hjc180926/26mspm0-car/hardware/schematic-V1.0-2026-08-01.pdf

# RGB

# 电源接口DC005+XT60

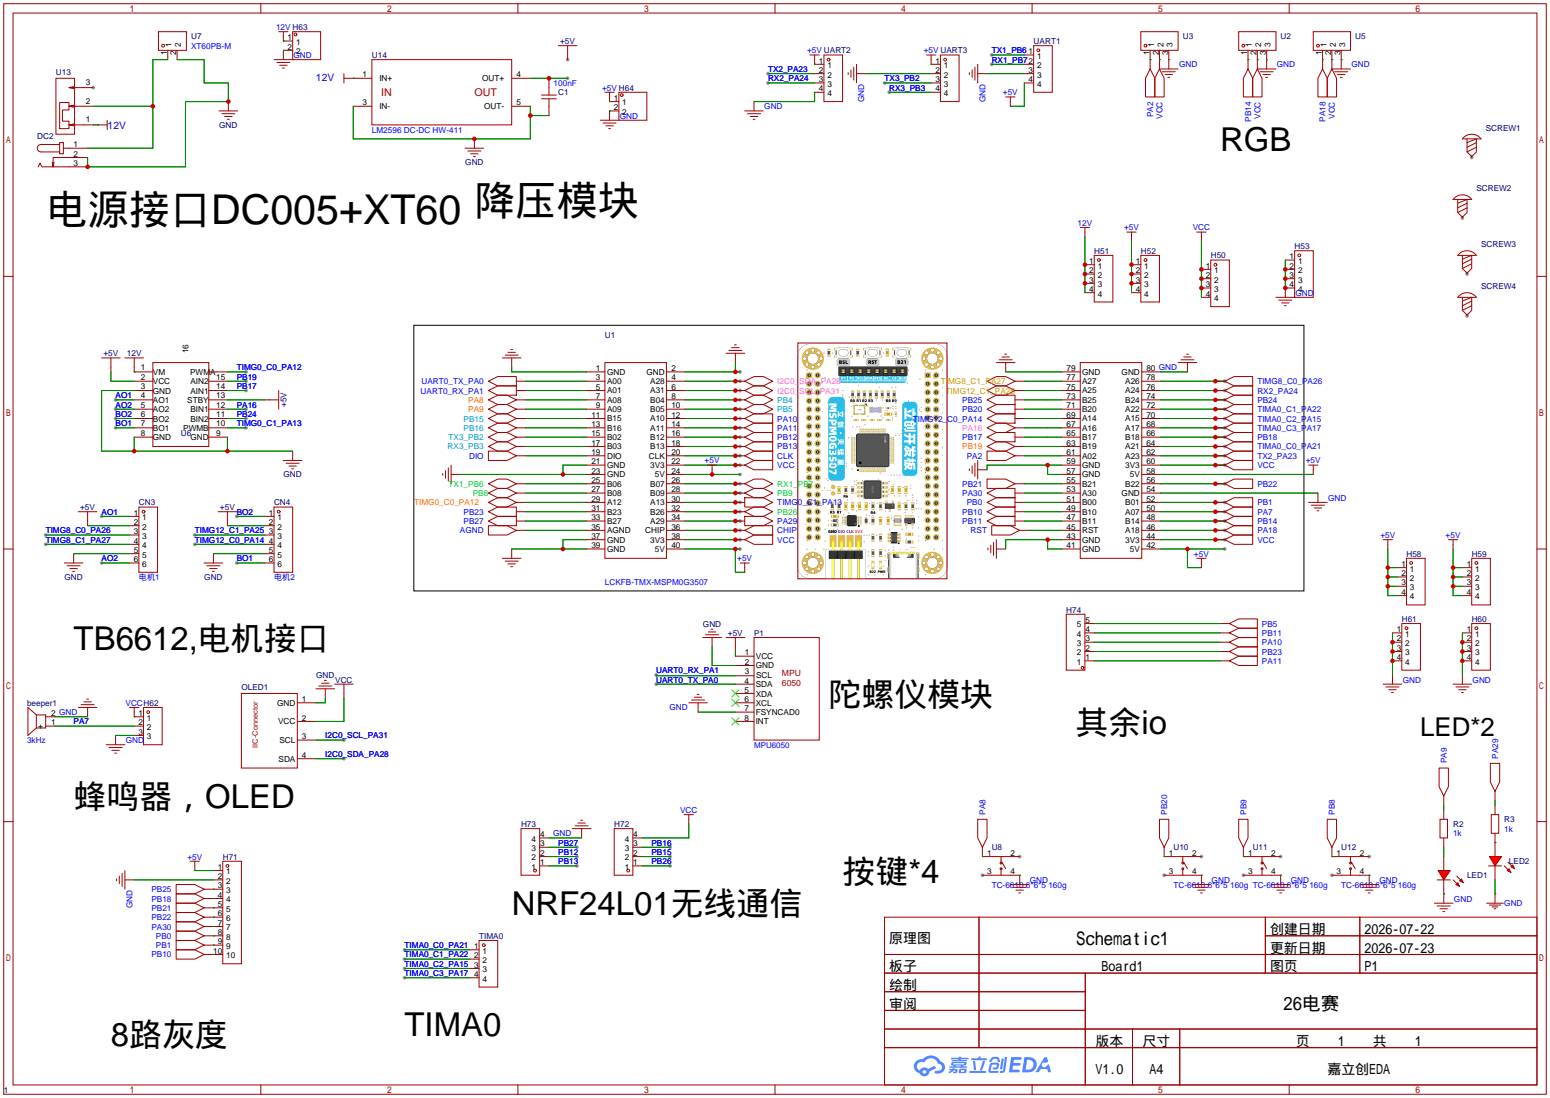
[picture p1: page 1]

PWMB 10 BIN2 11 BIN1 12 STBY 13 AIN1 14 AIN2 15 PWMA ¹⁶

原理图 | Schematic1 | 创建日期 | 2026-07-22

更新日期 | 2026-07-23

板子 | Board1 | 图页 | P1
绘制 | | 26电赛
审阅

V1.0 | A4 | 嘉立创EDA
