hjc180926/26mspm0-car/k230-ball-balance/main.py

import os
import ujson
import aicube
from media.sensor import *
from media.display import *
from media.media import *
from time import *
import nncase_runtime as nn
import ulab.numpy as np
import time
import utime
import image
import gc

# ========== 显示配置 ==========
display_mode = "lcd"
if display_mode == "lcd":
    DISPLAY_WIDTH = ALIGN_UP(800, 16)
    DISPLAY_HEIGHT = 480
else:
    DISPLAY_WIDTH = ALIGN_UP(1920, 16)
    DISPLAY_HEIGHT = 1080

# AI推理通道分辨率
OUT_RGB888P_WIDTH = ALIGN_UP(1080, 16)
OUT_RGB888P_HEIGH = 720

# ========== 颜色配置 ==========
color_four = [(255, 220, 20, 60), (255, 119, 11, 32), (255, 0, 0, 142), (255, 0, 0, 230),
        (255, 106, 0, 228), (255, 0, 60, 100), (255, 0, 80, 100), (255, 0, 0, 70),
        (255, 0, 0, 192), (255, 250, 170, 30), (255, 100, 170, 30), (255, 220, 220, 0),
        (255, 175, 116, 175), (255, 250, 0, 30), (255, 165, 42, 42), (255, 255, 77, 255),
        (255, 0, 226, 252), (255, 182, 182, 255), (255, 0, 82, 0), (255, 120, 166, 157),
        (255, 110, 76, 0), (255, 174, 57, 255), (255, 199, 100, 0), (255, 72, 0, 118),
        (255, 255, 179, 240), (255, 0, 125, 92), (255, 209, 0, 151), (255, 188, 208, 182),
        (255, 0, 220, 176), (255, 255, 99, 164), (255, 92, 0, 73), (255, 133, 129, 255),
        (255, 78, 180, 255), (255, 0, 228, 0), (255, 174, 255, 243), (255, 45, 89, 255),
        (255, 134, 134, 103), (255, 145, 148, 174), (255, 255, 208, 186),
        (255, 197, 226, 255), (255, 171, 134, 1), (255, 109, 63, 54), (255, 207, 138, 255),
        (255, 151, 0, 95), (255, 9, 80, 61), (255, 84, 105, 51), (255, 74, 65, 105),
        (255, 166, 196, 102), (255, 208, 195, 210), (255, 255, 109, 65), (255, 0, 143, 149),
        (255, 179, 0, 194), (255, 209, 99, 106), (255, 5, 121, 0), (255, 227, 255, 205),
        (255, 147, 186, 208), (255, 153, 69, 1), (255, 3, 95, 161), (255, 163, 255, 0),
        (255, 119, 0, 170), (255, 0, 182, 199), (255, 0, 165, 120), (255, 183, 130, 88),
        (255, 95, 32, 0), (255, 130, 114, 135), (255, 110, 129, 133), (255, 166, 74, 118),
        (255, 219, 142, 185), (255, 79, 210, 114), (255, 178, 90, 62), (255, 65, 70, 15),
        (255, 127, 167, 115), (255, 59, 105, 106), (255, 142, 108, 45), (255, 196, 172, 0),
        (255, 95, 54, 80), (255, 128, 76, 255), (255, 201, 57, 1), (255, 246, 0, 122),
        (255, 191, 162, 208)]

# ========== 模型路径配置 ==========
root_path = "/sdcard/mp_deployment_source/"
config_path = root_path + "deploy_config.json"
deploy_conf = {}
debug_mode = 1

# ========== 位置换算校准参数（必须按实际画面校准） ==========
# 摆杆中心点（0cm刻度）对应的AI画面x像素坐标
CENTER_X_PIXEL = 540
# 每1厘米对应的像素数量（摆杆总长25cm，总像素数 / 25 可得初始值）
PIXEL_PER_CM = 43.2
# ==============================================================

class ScopedTiming:
    def __init__(self, info="", enable_profile=True):
        self.info = info
        self.enable_profile = enable_profile

    def __enter__(self):
        if self.enable_profile:
            self.start_time = time.time_ns()
        return self

    def __exit__(self, exc_type, exc_value, traceback):
        if self.enable_profile:
            elapsed_time = time.time_ns() - self.start_time
            print(f"{self.info} took {elapsed_time / 1000000:.2f} ms")

def read_deploy_config(config_path):
    with open(config_path, 'r') as json_file:
        try:
            config = ujson.load(json_file)
        except ValueError as e:
            print("JSON 解析错误:", e)
    return config

def detection():
    print("=== 钢珠位置检测启动 ===")
    deploy_conf = read_deploy_config(config_path)
    kmodel_name = deploy_conf["kmodel_path"]
    labels = deploy_conf["categories"]
    confidence_threshold = deploy_conf["confidence_threshold"]
    nms_threshold = deploy_conf["nms_threshold"]
    img_size = deploy_conf["img_size"]
    num_classes = deploy_conf["num_classes"]
    nms_option = deploy_conf["nms_option"]
    model_type = deploy_conf["model_type"]
    
    if model_type == "AnchorBaseDet":
        anchors = deploy_conf["anchors"][0] + deploy_conf["anchors"][1] + deploy_conf["anchors"][2]
    
    kmodel_frame_size = img_size
    frame_size = [OUT_RGB888P_WIDTH, OUT_RGB888P_HEIGH]
    strides = [8, 16, 32]

    # 计算padding参数
    ori_w = OUT_RGB888P_WIDTH
    ori_h = OUT_RGB888P_HEIGH
    width = kmodel_frame_size[0]
    height = kmodel_frame_size[1]
    ratiow = float(width) / ori_w
    ratioh = float(height) / ori_h
    ratio = ratiow if ratiow < ratioh else ratioh
    new_w = int(ratio * ori_w)
    new_h = int(ratio * ori_h)
    dw = float(width - new_w) / 2
    dh = float(height - new_h) / 2
    top = int(round(dh - 0.1))
    bottom = int(round(dh + 0.1))
    left = int(round(dw - 0.1))
    right = int(round(dw - 0.1))

    # 初始化KPU和AI2D
    kpu = nn.kpu()
    ai2d = nn.ai2d()
    kpu.load_kmodel(root_path + kmodel_name)
    ai2d.set_dtype(nn.ai2d_format.NCHW_FMT,
                   nn.ai2d_format.NCHW_FMT,
                   np.uint8, np.uint8)
    ai2d.set_pad_param(True, [0,0,0,0,top,bottom,left,right], 0, [114,114,114])
    ai2d.set_resize_param(True, nn.interp_method.tf_bilinear, nn.interp_mode.half_pixel)
    ai2d_builder = ai2d.build([1,3,OUT_RGB888P_HEIGH,OUT_RGB888P_WIDTH], [1,3,height,width])

    # 初始化摄像头
    sensor = Sensor()
    sensor.reset()
    sensor.set_hmirror(False)
    sensor.set_vflip(False)
    sensor.set_framesize(width=DISPLAY_WIDTH, height=DISPLAY_HEIGHT)
    sensor.set_pixformat(PIXEL_FORMAT_YUV_SEMIPLANAR_420)
    sensor.set_framesize(width=OUT_RGB888P_WIDTH, height=OUT_RGB888P_HEIGH, chn=CAM_CHN_ID_2)
    sensor.set_pixformat(PIXEL_FORMAT_RGB_888_PLANAR, chn=CAM_CHN_ID_2)
    
    sensor_bind_info = sensor.bind_info(x=0, y=0, chn=CAM_CHN_ID_0)
    Display.bind_layer(**sensor_bind_info, layer=Display.LAYER_VIDEO1)
    
    if display_mode == "lcd":
        Display.init(Display.ST7701, to_ide=False)
    else:
        Display.init(Display.LT9611, to_ide=False)

    # 创建OSD绘图层
    osd_img = image.Image(DISPLAY_WIDTH, DISPLAY_HEIGHT, image.ARGB8888)
    
    try:
        MediaManager.init()
        sensor.run()
        rgb888p_img = None
        ai2d_input_tensor = None
        data = np.ones((1,3,width,height), dtype=np.uint8)
        ai2d_output_tensor = nn.from_numpy(data)
        
        while True:
            with ScopedTiming("total", debug_mode > 0):
                rgb888p_img = sensor.snapshot(chn=CAM_CHN_ID_2)
                
                if rgb888p_img.format() == image.RGBP888:
                    ai2d_input = rgb888p_img.to_numpy_ref()
                    ai2d_input_tensor = nn.from_numpy(ai2d_input)
                    ai2d_builder.run(ai2d_input_tensor, ai2d_output_tensor)

                    kpu.set_input_tensor(0, ai2d_output_tensor)
                    kpu.run()
                    
                    # 获取模型输出
                    results = []
                    for i in range(kpu.outputs_size()):
                        out_data = kpu.get_output_tensor(i)
                        result = out_data.to_numpy()
                        result = result.reshape((result.shape[0]*result.shape[1]*result.shape[2]*result.shape[3]))
                        del out_data
                        results.append(result)
                    gc.collect()

                    # 目标检测后处理
                    if model_type == "AnchorBaseDet":
                        det_boxes = aicube.anchorbasedet_post_process(
                            results[0], results[1], results[2],
                            kmodel_frame_size, frame_size, strides,
                            num_classes, confidence_threshold, nms_threshold, anchors, nms_option)
                    elif model_type == "GFLDet":
                        det_boxes = aicube.gfldet_post_process(
                            results[0], results[1], results[2],
                            kmodel_frame_size, frame_size, strides,
                            num_classes, confidence_threshold, nms_threshold, nms_option)
                    else:
                        det_boxes = aicube.anchorfreedet_post_process(
                            results[0], results[1], results[2],
                            kmodel_frame_size, frame_size, strides,
                            num_classes, confidence_threshold, nms_threshold, nms_option)
                    
                    osd_img.clear()
                    
                    # ========== 核心：钢珠位置计算与显示 ==========
                    if det_boxes:
                        # 取置信度最高的钢珠（第一个）
                        box = det_boxes[0]
                        cls_id = int(box[0])
                        score = box[1]
                        x1, y1, x2, y2 = box[2], box[3], box[4], box[5]
                        
                        # 1. 计算钢珠中心像素坐标（AI推理帧坐标系）
                        ball_cx_pixel = (x1 + x2) / 2
                        ball_cy_pixel = (y1 + y2) / 2
                        
                        # 2. 像素坐标换算为物理位置（cm，中心点为0，右正左负）
                        ball_pos_cm = (ball_cx_pixel - CENTER_X_PIXEL) / PIXEL_PER_CM
                        
                        # 3. 坐标映射到显示画面尺寸
                        disp_x1 = int(x1 * DISPLAY_WIDTH / OUT_RGB888P_WIDTH)
                        disp_y1 = int(y1 * DISPLAY_HEIGHT / OUT_RGB888P_HEIGH)
                        disp_x2 = int(x2 * DISPLAY_WIDTH / OUT_RGB888P_WIDTH)
                        disp_y2 = int(y2 * DISPLAY_HEIGHT / OUT_RGB888P_HEIGH)
                        disp_cx = int(ball_cx_pixel * DISPLAY_WIDTH / OUT_RGB888P_WIDTH)
                        disp_cy = int(ball_cy_pixel * DISPLAY_HEIGHT / OUT_RGB888P_HEIGH)
                        
                        # 4. 绘制检测框
                        osd_img.draw_rectangle(disp_x1, disp_y1, disp_x2-disp_x1, disp_y2-disp_y1,
                                               color=color_four[cls_id][1:])
                        
                        # 5. 绘制中心点标记
                        osd_img.draw_circle(disp_cx, disp_cy, 4, color=(255,255,0,255), thickness=2)
                        
                        # 6. 左上角叠加显示位置信息
                        info_text = f"位置: {ball_pos_cm:+.2f} cm"
                        pixel_text = f"X像素: {int(ball_cx_pixel)}"
                        score_text = f"置信度: {score:.2f}"
                        
                        osd_img.draw_string_advanced(20, 30, 36, info_text, color=(255,255,0,255))
                        osd_img.draw_string_advanced(20, 75, 28, pixel_text, color=(255,255,255,255))
                        osd_img.draw_string_advanced(20, 110, 28, score_text, color=(255,255,255,255))
                        
                        # 串口同步输出位置，方便校准
                        print(f"钢珠位置: {ball_pos_cm:+.2f} cm | X像素: {int(ball_cx_pixel)}")
                    else:
                        # 未检测到钢珠时的提示
                        osd_img.draw_string_advanced(20, 30, 36, "未检测到钢珠", color=(255,0,0,255))
                    
                    # 显示OSD层
                    Display.show_image(osd_img, 0, 0, Display.LAYER_OSD3)
                    gc.collect()
                
                rgb888p_img = None

    except Exception as e:
        print(f"运行异常: {e}")
        import sys
        sys.print_exception(e)
    finally:
        os.exitpoint(os.EXITPOINT_ENABLE_SLEEP)
        del ai2d_input_tensor
        del ai2d_output_tensor
        sensor.stop()
        Display.deinit()
        MediaManager.deinit()
        gc.collect()
        time.sleep(1)
        nn.shrink_memory_pool()
    print("检测结束")
    return 0

if __name__ == "__main__":
    detection()
