hjc180926/26mspm0-car/ti_msp_dl_config.c

/*
 * Copyright (c) 2023, Texas Instruments Incorporated
 * All rights reserved.
 *
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
 * *  Redistributions of source code must retain the above copyright
 *    notice, this list of conditions and the following disclaimer.
 *
 * *  Redistributions in binary form must reproduce the above copyright
 *    notice, this list of conditions and the following disclaimer in the
 *    documentation and/or other materials provided with the distribution.
 *
 * *  Neither the name of Texas Instruments Incorporated nor the names of
 *    its contributors may be used to endorse or promote products derived
 *    from this software without specific prior written permission.
 *
 * THIS SOFTWARE IS PROVIDED BY THE COPYRIGHT HOLDERS AND CONTRIBUTORS "AS IS"
 * AND ANY EXPRESS OR IMPLIED WARRANTIES, INCLUDING, BUT NOT LIMITED TO,
 * THE IMPLIED WARRANTIES OF MERCHANTABILITY AND FITNESS FOR A PARTICULAR
 * PURPOSE ARE DISCLAIMED. IN NO EVENT SHALL THE COPYRIGHT OWNER OR
 * CONTRIBUTORS BE LIABLE FOR ANY DIRECT, INDIRECT, INCIDENTAL, SPECIAL,
 * EXEMPLARY, OR CONSEQUENTIAL DAMAGES (INCLUDING, BUT NOT LIMITED TO,
 * PROCUREMENT OF SUBSTITUTE GOODS OR SERVICES; LOSS OF USE, DATA, OR PROFITS;
 * OR BUSINESS INTERRUPTION) HOWEVER CAUSED AND ON ANY THEORY OF LIABILITY,
 * WHETHER IN CONTRACT, STRICT LIABILITY, OR TORT (INCLUDING NEGLIGENCE OR
 * OTHERWISE) ARISING IN ANY WAY OUT OF THE USE OF THIS SOFTWARE,
 * EVEN IF ADVISED OF THE POSSIBILITY OF SUCH DAMAGE.
 */

/*
 *  ============ ti_msp_dl_config.c =============
 *  Configured MSPM0 DriverLib module definitions
 *
 *  DO NOT EDIT - This file is generated for the MSPM0G350X
 *  by the SysConfig tool.
 */

#include "ti_msp_dl_config.h"

DL_TimerG_backupConfig gQEI_ENCODER_LEFTBackup;

/*
 *  ======== SYSCFG_DL_init ========
 *  Perform any initialization needed before using any board APIs
 */
SYSCONFIG_WEAK void SYSCFG_DL_init(void)
{
    SYSCFG_DL_initPower();
    SYSCFG_DL_GPIO_init();
    /* Module-Specific Initializations*/
    SYSCFG_DL_SYSCTL_init();
    SYSCFG_DL_PWM_TB6612_init();
    SYSCFG_DL_QEI_ENCODER_LEFT_init();
    SYSCFG_DL_TIMER_0_init();
    SYSCFG_DL_I2C_0_init();
    SYSCFG_DL_UART_0_init();
    /* Ensure backup structures have no valid state */

	gQEI_ENCODER_LEFTBackup.backupRdy 	= false;



}
/*
 * User should take care to save and restore register configuration in application.
 * See Retention Configuration section for more details.
 */
SYSCONFIG_WEAK bool SYSCFG_DL_saveConfiguration(void)
{
    bool retStatus = true;

	retStatus &= DL_TimerG_saveConfiguration(QEI_ENCODER_LEFT_INST, &gQEI_ENCODER_LEFTBackup);

    return retStatus;
}


SYSCONFIG_WEAK bool SYSCFG_DL_restoreConfiguration(void)
{
    bool retStatus = true;

	retStatus &= DL_TimerG_restoreConfiguration(QEI_ENCODER_LEFT_INST, &gQEI_ENCODER_LEFTBackup, false);

    return retStatus;
}

SYSCONFIG_WEAK void SYSCFG_DL_initPower(void)
{
    DL_GPIO_reset(GPIOA);
    DL_GPIO_reset(GPIOB);
    DL_TimerG_reset(PWM_TB6612_INST);
    DL_TimerG_reset(QEI_ENCODER_LEFT_INST);
    DL_TimerG_reset(TIMER_0_INST);
    DL_I2C_reset(I2C_0_INST);
    DL_UART_Main_reset(UART_0_INST);

    DL_GPIO_enablePower(GPIOA);
    DL_GPIO_enablePower(GPIOB);
    DL_TimerG_enablePower(PWM_TB6612_INST);
    DL_TimerG_enablePower(QEI_ENCODER_LEFT_INST);
    DL_TimerG_enablePower(TIMER_0_INST);
    DL_I2C_enablePower(I2C_0_INST);
    DL_UART_Main_enablePower(UART_0_INST);
    delay_cycles(POWER_STARTUP_DELAY);
}

SYSCONFIG_WEAK void SYSCFG_DL_GPIO_init(void)
{

    DL_GPIO_initPeripheralAnalogFunction(GPIO_HFXIN_IOMUX);
    DL_GPIO_initPeripheralAnalogFunction(GPIO_HFXOUT_IOMUX);

    DL_GPIO_initPeripheralOutputFunction(GPIO_PWM_TB6612_C0_IOMUX,GPIO_PWM_TB6612_C0_IOMUX_FUNC);
    DL_GPIO_enableOutput(GPIO_PWM_TB6612_C0_PORT, GPIO_PWM_TB6612_C0_PIN);
    DL_GPIO_initPeripheralOutputFunction(GPIO_PWM_TB6612_C1_IOMUX,GPIO_PWM_TB6612_C1_IOMUX_FUNC);
    DL_GPIO_enableOutput(GPIO_PWM_TB6612_C1_PORT, GPIO_PWM_TB6612_C1_PIN);

    DL_GPIO_initPeripheralInputFunction(GPIO_QEI_ENCODER_LEFT_PHA_IOMUX,GPIO_QEI_ENCODER_LEFT_PHA_IOMUX_FUNC);
    DL_GPIO_initPeripheralInputFunction(GPIO_QEI_ENCODER_LEFT_PHB_IOMUX,GPIO_QEI_ENCODER_LEFT_PHB_IOMUX_FUNC);

    DL_GPIO_initPeripheralInputFunctionFeatures(GPIO_I2C_0_IOMUX_SDA,
        GPIO_I2C_0_IOMUX_SDA_FUNC, DL_GPIO_INVERSION_DISABLE,
        DL_GPIO_RESISTOR_NONE, DL_GPIO_HYSTERESIS_DISABLE,
        DL_GPIO_WAKEUP_DISABLE);
    DL_GPIO_initPeripheralInputFunctionFeatures(GPIO_I2C_0_IOMUX_SCL,
        GPIO_I2C_0_IOMUX_SCL_FUNC, DL_GPIO_INVERSION_DISABLE,
        DL_GPIO_RESISTOR_NONE, DL_GPIO_HYSTERESIS_DISABLE,
        DL_GPIO_WAKEUP_DISABLE);
    DL_GPIO_enableHiZ(GPIO_I2C_0_IOMUX_SDA);
    DL_GPIO_enableHiZ(GPIO_I2C_0_IOMUX_SCL);

    DL_GPIO_initPeripheralOutputFunction(
        GPIO_UART_0_IOMUX_TX, GPIO_UART_0_IOMUX_TX_FUNC);
    DL_GPIO_initPeripheralInputFunction(
        GPIO_UART_0_IOMUX_RX, GPIO_UART_0_IOMUX_RX_FUNC);

    DL_GPIO_initDigitalOutput(LED_SIG_1_PIN_9_IOMUX);

    DL_GPIO_initDigitalInputFeatures(GPIO_MPU6050_INT_PIN_MPU6050_INT_IOMUX,
		 DL_GPIO_INVERSION_DISABLE, DL_GPIO_RESISTOR_PULL_UP,
		 DL_GPIO_HYSTERESIS_DISABLE, DL_GPIO_WAKEUP_DISABLE);

    DL_GPIO_initDigitalOutput(LED_SIG_2_PIN_29_IOMUX);

    DL_GPIO_initDigitalInputFeatures(GPIO_BTN_U8_PIN_BTN_U8_IOMUX,
		 DL_GPIO_INVERSION_DISABLE, DL_GPIO_RESISTOR_PULL_UP,
		 DL_GPIO_HYSTERESIS_DISABLE, DL_GPIO_WAKEUP_DISABLE);

    DL_GPIO_initDigitalInputFeatures(GPIO_BTN_U10_PIN_BTN_U10_IOMUX,
		 DL_GPIO_INVERSION_DISABLE, DL_GPIO_RESISTOR_PULL_UP,
		 DL_GPIO_HYSTERESIS_DISABLE, DL_GPIO_WAKEUP_DISABLE);

    DL_GPIO_initDigitalInputFeatures(GPIO_BTN_U11_PIN_BTN_U11_IOMUX,
		 DL_GPIO_INVERSION_DISABLE, DL_GPIO_RESISTOR_PULL_UP,
		 DL_GPIO_HYSTERESIS_DISABLE, DL_GPIO_WAKEUP_DISABLE);

    DL_GPIO_initDigitalInputFeatures(GPIO_BTN_U12_PIN_BTN_U12_IOMUX,
		 DL_GPIO_INVERSION_DISABLE, DL_GPIO_RESISTOR_PULL_UP,
		 DL_GPIO_HYSTERESIS_DISABLE, DL_GPIO_WAKEUP_DISABLE);

    DL_GPIO_initDigitalInputFeatures(GPIO_TRK_CH0_PIN_TRK_CH0_IOMUX,
		 DL_GPIO_INVERSION_DISABLE, DL_GPIO_RESISTOR_PULL_UP,
		 DL_GPIO_HYSTERESIS_DISABLE, DL_GPIO_WAKEUP_DISABLE);

    DL_GPIO_initDigitalInputFeatures(GPIO_TRK_CH1_PIN_TRK_CH1_IOMUX,
		 DL_GPIO_INVERSION_DISABLE, DL_GPIO_RESISTOR_PULL_UP,
		 DL_GPIO_HYSTERESIS_DISABLE, DL_GPIO_WAKEUP_DISABLE);

    DL_GPIO_initDigitalInputFeatures(GPIO_TRK_CH2_PIN_TRK_CH2_IOMUX,
		 DL_GPIO_INVERSION_DISABLE, DL_GPIO_RESISTOR_PULL_UP,
		 DL_GPIO_HYSTERESIS_DISABLE, DL_GPIO_WAKEUP_DISABLE);

    DL_GPIO_initDigitalInputFeatures(GPIO_TRK_CH3_PIN_TRK_CH3_IOMUX,
		 DL_GPIO_INVERSION_DISABLE, DL_GPIO_RESISTOR_PULL_UP,
		 DL_GPIO_HYSTERESIS_DISABLE, DL_GPIO_WAKEUP_DISABLE);

    DL_GPIO_initDigitalInputFeatures(GPIO_TRK_CH4_PIN_TRK_CH4_IOMUX,
		 DL_GPIO_INVERSION_DISABLE, DL_GPIO_RESISTOR_PULL_UP,
		 DL_GPIO_HYSTERESIS_DISABLE, DL_GPIO_WAKEUP_DISABLE);

    DL_GPIO_initDigitalOutput(BUZZER_PIN_7_IOMUX);

    DL_GPIO_initDigitalInputFeatures(GPIO_TRK_CH5_PIN_TRK_CH5_IOMUX,
		 DL_GPIO_INVERSION_DISABLE, DL_GPIO_RESISTOR_PULL_UP,
		 DL_GPIO_HYSTERESIS_DISABLE, DL_GPIO_WAKEUP_DISABLE);

    DL_GPIO_initDigitalInputFeatures(GPIO_TRK_CH6_PIN_TRK_CH6_IOMUX,
		 DL_GPIO_INVERSION_DISABLE, DL_GPIO_RESISTOR_PULL_UP,
		 DL_GPIO_HYSTERESIS_DISABLE, DL_GPIO_WAKEUP_DISABLE);

    DL_GPIO_initDigitalInputFeatures(GPIO_TRK_CH7_PIN_TRK_CH7_IOMUX,
		 DL_GPIO_INVERSION_DISABLE, DL_GPIO_RESISTOR_PULL_UP,
		 DL_GPIO_HYSTERESIS_DISABLE, DL_GPIO_WAKEUP_DISABLE);

    DL_GPIO_initDigitalOutput(GPIO_OLED_SW_I2C_PIN_OLED_SDA_IOMUX);

    DL_GPIO_initDigitalOutput(GPIO_OLED_SW_I2C_PIN_OLED_SCL_IOMUX);

    DL_GPIO_initDigitalOutput(GPIO_TB6612_PIN_AIN1_IOMUX);

    DL_GPIO_initDigitalOutput(GPIO_TB6612_PIN_AIN2_IOMUX);

    DL_GPIO_initDigitalOutput(GPIO_TB6612_PIN_BIN1_IOMUX);

    DL_GPIO_initDigitalOutput(GPIO_TB6612_PIN_BIN2_IOMUX);

    DL_GPIO_initDigitalInputFeatures(GPIO_ENCODER_RIGHT_PIN_RIGHT_A_IOMUX,
		 DL_GPIO_INVERSION_DISABLE, DL_GPIO_RESISTOR_PULL_UP,
		 DL_GPIO_HYSTERESIS_DISABLE, DL_GPIO_WAKEUP_DISABLE);

    DL_GPIO_initDigitalInputFeatures(GPIO_ENCODER_RIGHT_PIN_RIGHT_B_IOMUX,
		 DL_GPIO_INVERSION_DISABLE, DL_GPIO_RESISTOR_PULL_UP,
		 DL_GPIO_HYSTERESIS_DISABLE, DL_GPIO_WAKEUP_DISABLE);

    DL_GPIO_clearPins(GPIOA, LED_SIG_1_PIN_9_PIN |
		LED_SIG_2_PIN_29_PIN |
		BUZZER_PIN_7_PIN |
		GPIO_OLED_SW_I2C_PIN_OLED_SDA_PIN |
		GPIO_OLED_SW_I2C_PIN_OLED_SCL_PIN |
		GPIO_TB6612_PIN_BIN1_PIN);
    DL_GPIO_enableOutput(GPIOA, LED_SIG_1_PIN_9_PIN |
		LED_SIG_2_PIN_29_PIN |
		BUZZER_PIN_7_PIN |
		GPIO_OLED_SW_I2C_PIN_OLED_SDA_PIN |
		GPIO_OLED_SW_I2C_PIN_OLED_SCL_PIN |
		GPIO_TB6612_PIN_BIN1_PIN);
    DL_GPIO_setLowerPinsPolarity(GPIOA, DL_GPIO_PIN_14_EDGE_RISE_FALL);
    DL_GPIO_setUpperPinsPolarity(GPIOA, DL_GPIO_PIN_25_EDGE_RISE_FALL);
    DL_GPIO_clearInterruptStatus(GPIOA, GPIO_ENCODER_RIGHT_PIN_RIGHT_A_PIN |
		GPIO_ENCODER_RIGHT_PIN_RIGHT_B_PIN);
    DL_GPIO_enableInterrupt(GPIOA, GPIO_ENCODER_RIGHT_PIN_RIGHT_A_PIN |
		GPIO_ENCODER_RIGHT_PIN_RIGHT_B_PIN);
    DL_GPIO_clearPins(GPIOB, GPIO_TB6612_PIN_AIN1_PIN |
		GPIO_TB6612_PIN_AIN2_PIN |
		GPIO_TB6612_PIN_BIN2_PIN);
    DL_GPIO_enableOutput(GPIOB, GPIO_TB6612_PIN_AIN1_PIN |
		GPIO_TB6612_PIN_AIN2_PIN |
		GPIO_TB6612_PIN_BIN2_PIN);
    DL_GPIO_setLowerPinsPolarity(GPIOB, DL_GPIO_PIN_4_EDGE_FALL);
    DL_GPIO_clearInterruptStatus(GPIOB, GPIO_MPU6050_INT_PIN_MPU6050_INT_PIN);
    DL_GPIO_enableInterrupt(GPIOB, GPIO_MPU6050_INT_PIN_MPU6050_INT_PIN);

}


static const DL_SYSCTL_SYSPLLConfig gSYSPLLConfig = {
    .inputFreq              = DL_SYSCTL_SYSPLL_INPUT_FREQ_32_48_MHZ,
	.rDivClk2x              = 1,
	.rDivClk1               = 0,
	.rDivClk0               = 0,
	.enableCLK2x            = DL_SYSCTL_SYSPLL_CLK2X_DISABLE,
	.enableCLK1             = DL_SYSCTL_SYSPLL_CLK1_DISABLE,
	.enableCLK0             = DL_SYSCTL_SYSPLL_CLK0_ENABLE,
	.sysPLLMCLK             = DL_SYSCTL_SYSPLL_MCLK_CLK0,
	.sysPLLRef              = DL_SYSCTL_SYSPLL_REF_HFCLK,
	.qDiv                   = 3,
	.pDiv                   = DL_SYSCTL_SYSPLL_PDIV_1
};
SYSCONFIG_WEAK void SYSCFG_DL_SYSCTL_init(void)
{

	//Low Power Mode is configured to be SLEEP0
    DL_SYSCTL_setBORThreshold(DL_SYSCTL_BOR_THRESHOLD_LEVEL_0);
    DL_SYSCTL_setFlashWaitState(DL_SYSCTL_FLASH_WAIT_STATE_2);

    
	DL_SYSCTL_setSYSOSCFreq(DL_SYSCTL_SYSOSC_FREQ_BASE);
	/* Set default configuration */
	DL_SYSCTL_disableHFXT();
	DL_SYSCTL_disableSYSPLL();
    DL_SYSCTL_setHFCLKSourceHFXTParams(DL_SYSCTL_HFXT_RANGE_32_48_MHZ,10, true);
    DL_SYSCTL_configSYSPLL((DL_SYSCTL_SYSPLLConfig *) &gSYSPLLConfig);
    DL_SYSCTL_setULPCLKDivider(DL_SYSCTL_ULPCLK_DIV_2);
    DL_SYSCTL_enableMFCLK();
    DL_SYSCTL_setMCLKSource(SYSOSC, HSCLK, DL_SYSCTL_HSCLK_SOURCE_SYSPLL);
    /* INT_GROUP1 Priority */
    NVIC_SetPriority(GPIOA_INT_IRQn, 3);

}


/*
 * Timer clock configuration to be sourced by  / 1 (40000000 Hz)
 * timerClkFreq = (timerClkSrc / (timerClkDivRatio * (timerClkPrescale + 1)))
 *   40000000 Hz = 40000000 Hz / (1 * (0 + 1))
 */
static const DL_TimerG_ClockConfig gPWM_TB6612ClockConfig = {
    .clockSel = DL_TIMER_CLOCK_BUSCLK,
    .divideRatio = DL_TIMER_CLOCK_DIVIDE_1,
    .prescale = 0U
};

static const DL_TimerG_PWMConfig gPWM_TB6612Config = {
    .pwmMode = DL_TIMER_PWM_MODE_EDGE_ALIGN,
    .period = 2000,
    .isTimerWithFourCC = false,
    .startTimer = DL_TIMER_STOP,
};

SYSCONFIG_WEAK void SYSCFG_DL_PWM_TB6612_init(void) {

    DL_TimerG_setClockConfig(
        PWM_TB6612_INST, (DL_TimerG_ClockConfig *) &gPWM_TB6612ClockConfig);

    DL_TimerG_initPWMMode(
        PWM_TB6612_INST, (DL_TimerG_PWMConfig *) &gPWM_TB6612Config);

    // Set Counter control to the smallest CC index being used
    DL_TimerG_setCounterControl(PWM_TB6612_INST,DL_TIMER_CZC_CCCTL0_ZCOND,DL_TIMER_CAC_CCCTL0_ACOND,DL_TIMER_CLC_CCCTL0_LCOND);

    DL_TimerG_setCaptureCompareOutCtl(PWM_TB6612_INST, DL_TIMER_CC_OCTL_INIT_VAL_LOW,
		DL_TIMER_CC_OCTL_INV_OUT_DISABLED, DL_TIMER_CC_OCTL_SRC_FUNCVAL,
		DL_TIMERG_CAPTURE_COMPARE_0_INDEX);

    DL_TimerG_setCaptCompUpdateMethod(PWM_TB6612_INST, DL_TIMER_CC_UPDATE_METHOD_IMMEDIATE, DL_TIMERG_CAPTURE_COMPARE_0_INDEX);
    DL_TimerG_setCaptureCompareValue(PWM_TB6612_INST, 2000, DL_TIMER_CC_0_INDEX);

    DL_TimerG_setCaptureCompareOutCtl(PWM_TB6612_INST, DL_TIMER_CC_OCTL_INIT_VAL_LOW,
		DL_TIMER_CC_OCTL_INV_OUT_DISABLED, DL_TIMER_CC_OCTL_SRC_FUNCVAL,
		DL_TIMERG_CAPTURE_COMPARE_1_INDEX);

    DL_TimerG_setCaptCompUpdateMethod(PWM_TB6612_INST, DL_TIMER_CC_UPDATE_METHOD_IMMEDIATE, DL_TIMERG_CAPTURE_COMPARE_1_INDEX);
    DL_TimerG_setCaptureCompareValue(PWM_TB6612_INST, 2000, DL_TIMER_CC_1_INDEX);

    DL_TimerG_enableClock(PWM_TB6612_INST);


    
    DL_TimerG_setCCPDirection(PWM_TB6612_INST , DL_TIMER_CC0_OUTPUT | DL_TIMER_CC1_OUTPUT );


}


static const DL_TimerG_ClockConfig gQEI_ENCODER_LEFTClockConfig = {
    .clockSel = DL_TIMER_CLOCK_BUSCLK,
    .divideRatio = DL_TIMER_CLOCK_DIVIDE_1,
    .prescale = 0U
};


SYSCONFIG_WEAK void SYSCFG_DL_QEI_ENCODER_LEFT_init(void) {

    DL_TimerG_setClockConfig(
        QEI_ENCODER_LEFT_INST, (DL_TimerG_ClockConfig *) &gQEI_ENCODER_LEFTClockConfig);

    DL_TimerG_configQEI(QEI_ENCODER_LEFT_INST, DL_TIMER_QEI_MODE_2_INPUT,
        DL_TIMER_CC_INPUT_INV_NOINVERT, DL_TIMER_CC_0_INDEX);
    DL_TimerG_configQEI(QEI_ENCODER_LEFT_INST, DL_TIMER_QEI_MODE_2_INPUT,
        DL_TIMER_CC_INPUT_INV_NOINVERT, DL_TIMER_CC_1_INDEX);
    DL_TimerG_setLoadValue(QEI_ENCODER_LEFT_INST, 65535);
    DL_TimerG_enableClock(QEI_ENCODER_LEFT_INST);
}



/*
 * Timer clock configuration to be sourced by BUSCLK /  (80000000 Hz)
 * timerClkFreq = (timerClkSrc / (timerClkDivRatio * (timerClkPrescale + 1)))
 *   80000000 Hz = 80000000 Hz / (1 * (0 + 1))
 */
static const DL_TimerG_ClockConfig gTIMER_0ClockConfig = {
    .clockSel    = DL_TIMER_CLOCK_BUSCLK,
    .divideRatio = DL_TIMER_CLOCK_DIVIDE_1,
    .prescale    = 0U,
};

/*
 * Timer load value (where the counter starts from) is calculated as (timerPeriod * timerClockFreq) - 1
 * TIMER_0_INST_LOAD_VALUE = (10 ms * 80000000 Hz) - 1
 */
static const DL_TimerG_TimerConfig gTIMER_0TimerConfig = {
    .period     = TIMER_0_INST_LOAD_VALUE,
    .timerMode  = DL_TIMER_TIMER_MODE_PERIODIC,
    .startTimer = DL_TIMER_STOP,
};

SYSCONFIG_WEAK void SYSCFG_DL_TIMER_0_init(void) {

    DL_TimerG_setClockConfig(TIMER_0_INST,
        (DL_TimerG_ClockConfig *) &gTIMER_0ClockConfig);

    DL_TimerG_initTimerMode(TIMER_0_INST,
        (DL_TimerG_TimerConfig *) &gTIMER_0TimerConfig);
    DL_TimerG_enableInterrupt(TIMER_0_INST , DL_TIMERG_INTERRUPT_ZERO_EVENT);
    DL_TimerG_enableClock(TIMER_0_INST);





}


static const DL_I2C_ClockConfig gI2C_0ClockConfig = {
    .clockSel = DL_I2C_CLOCK_BUSCLK,
    .divideRatio = DL_I2C_CLOCK_DIVIDE_1,
};

SYSCONFIG_WEAK void SYSCFG_DL_I2C_0_init(void) {

    DL_I2C_setClockConfig(I2C_0_INST,
        (DL_I2C_ClockConfig *) &gI2C_0ClockConfig);
    DL_I2C_setAnalogGlitchFilterPulseWidth(I2C_0_INST,
        DL_I2C_ANALOG_GLITCH_FILTER_WIDTH_50NS);
    DL_I2C_enableAnalogGlitchFilter(I2C_0_INST);

    /* Configure Controller Mode */
    DL_I2C_resetControllerTransfer(I2C_0_INST);
    /* Set frequency to 100000 Hz*/
    DL_I2C_setTimerPeriod(I2C_0_INST, 39);
    DL_I2C_setControllerTXFIFOThreshold(I2C_0_INST, DL_I2C_TX_FIFO_LEVEL_EMPTY);
    DL_I2C_setControllerRXFIFOThreshold(I2C_0_INST, DL_I2C_RX_FIFO_LEVEL_BYTES_1);
    DL_I2C_enableControllerClockStretching(I2C_0_INST);


    /* Enable module */
    DL_I2C_enableController(I2C_0_INST);


}


static const DL_UART_Main_ClockConfig gUART_0ClockConfig = {
    .clockSel    = DL_UART_MAIN_CLOCK_BUSCLK,
    .divideRatio = DL_UART_MAIN_CLOCK_DIVIDE_RATIO_1
};

static const DL_UART_Main_Config gUART_0Config = {
    .mode        = DL_UART_MAIN_MODE_NORMAL,
    .direction   = DL_UART_MAIN_DIRECTION_TX_RX,
    .flowControl = DL_UART_MAIN_FLOW_CONTROL_NONE,
    .parity      = DL_UART_MAIN_PARITY_NONE,
    .wordLength  = DL_UART_MAIN_WORD_LENGTH_8_BITS,
    .stopBits    = DL_UART_MAIN_STOP_BITS_ONE
};

SYSCONFIG_WEAK void SYSCFG_DL_UART_0_init(void)
{
    DL_UART_Main_setClockConfig(UART_0_INST, (DL_UART_Main_ClockConfig *) &gUART_0ClockConfig);

    DL_UART_Main_init(UART_0_INST, (DL_UART_Main_Config *) &gUART_0Config);
    /*
     * Configure baud rate by setting oversampling and baud rate divisors.
     *  Target baud rate: 9600
     *  Actual baud rate: 9599.81
     */
    DL_UART_Main_setOversampling(UART_0_INST, DL_UART_OVERSAMPLING_RATE_16X);
    DL_UART_Main_setBaudRateDivisor(UART_0_INST, UART_0_IBRD_40_MHZ_9600_BAUD, UART_0_FBRD_40_MHZ_9600_BAUD);


    /* Configure Interrupts */
    DL_UART_Main_enableInterrupt(UART_0_INST,
                                 DL_UART_MAIN_INTERRUPT_RX);


    DL_UART_Main_enable(UART_0_INST);
}
