hjc180926/26mspm0-car/Component/mpu6050/IIC.h

#ifndef __IIC_H
#define __IIC_H

#include <stdint.h>

void IIC_Init(void);
void IIC_Start(void);
void IIC_Stop(void);
void IIC_Send_Byte(uint8_t txd);
uint8_t IIC_Read_Byte(uint8_t ack);
uint8_t IIC_Wait_Ack(void);

#endif
