hjc180926/26mspm0-car/(commit log)

2026-07-27 v01 速度闭环（无 RTOS）
2026-07-27 v02 接入 MPU6050 姿态传感器
2026-07-28 v03 加入 TB6612 电机驱动
2026-07-28 v04 加入 yaw 角度闭环
2026-07-28 v05 加入 4 个按键输入
2026-07-28 v06 加入 5 路灰度循迹
2026-07-29 v07 灰度循迹调试与参数优化
2026-07-29 v08 扩展为 8 路灰度，16 秒完成一圈
2026-07-29 v09 修复 OLED 显示报错
2026-07-29 v10 整理电机控制与循迹逻辑
2026-07-29 v11 加入编码器测速闭环
2026-07-31 v12 编码器版 8 路循迹
2026-10-22 docs: 添加版本说明与新手指引
2026-10-22 feat: 加入 K230 视觉钢球平衡舵机 PID 代码
2026-10-22 feat: 加入主板原理图、K230 基础检测版，更新舵机闭环脚本至 08-01 版
